TinyChipHub/bitaxeGamma-TCH/(commit log)

2024-09-05 Add logo
    [bitaxeGamma-B_Cu.gbr, bitaxeGamma-B_Mask.gbr, bitaxeGamma-B_Paste.gbr, bitaxeGamma-B_Silkscreen.gbr, bitaxeGamma-Edge_Cuts.gbr, bitaxeGamma-F_Cu.gbr, bitaxeGamma-F_Mask.gbr, bitaxeGamma-F_Paste.gbr]
2024-09-05 Add ESD protection to TPS
    [bitaxeGamma BOM.csv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]
2024-09-06 update to 601 and TVS protection
    [bitaxeGamma-B_Cu.gbr, bitaxeGamma-B_Mask.gbr, bitaxeGamma-B_Paste.gbr, bitaxeGamma-B_Silkscreen.gbr, bitaxeGamma-Edge_Cuts.gbr, bitaxeGamma-F_Cu.gbr, bitaxeGamma-F_Mask.gbr, bitaxeGamma-F_Paste.gbr]
2025-07-07 bump to 602
    [bitaxeGamma-B_Cu.gbr, bitaxeGamma-B_Mask.gbr, bitaxeGamma-B_Paste.gbr, bitaxeGamma-B_Silkscreen.gbr, bitaxeGamma-Edge_Cuts.gbr, bitaxeGamma-F_Cu.gbr, bitaxeGamma-F_Mask.gbr, bitaxeGamma-F_Paste.gbr]
